GadgetReboot/16x16_Analog_Switch/README.md

# I2C Controlled 16x16_Analog_Switch
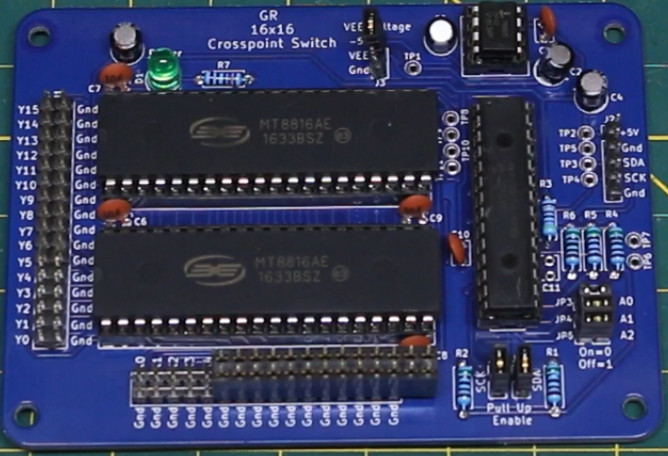
[picture p1: Assembled_PCB.jpg]
PCB
<br><br><BR><BR>
MT8816 based 16x16 Analog Switch Matrix
