GadgetReboot/16x16_Analog_Switch/GR_MT8816_Breakout_Sch.pdf

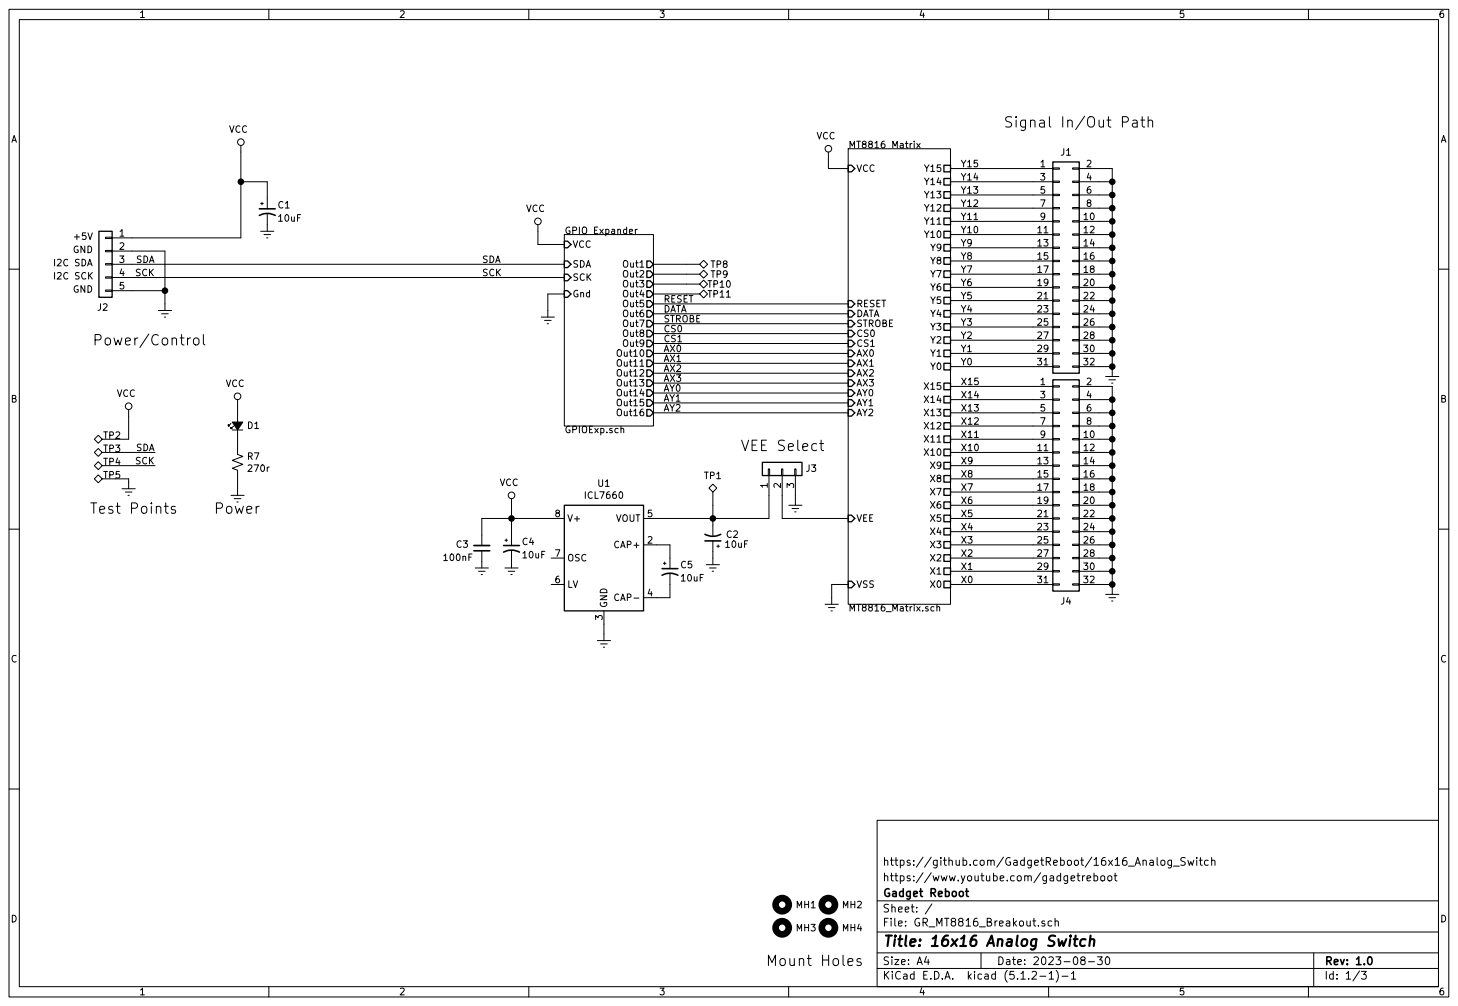
[picture p2: page 1]

J1 Signal In/Out Path

J3 VEE SelectVCC GPIO Expander

9 | 10
11 | 12

21 | 22
23 | 24
25 | 26
27 | 28
29 | 30
31 | 32

13 | 14
15 | 16
17 | 18
19 | 20

https://github.com/GadgetReboot/16x16_Analog_Switch
https://www.youtube.com/gadgetreboot
File: GR_MT8816_Breakout.sch Sheet: / Gadget Reboot

Id: 1/3 Title: 16x16 Analog Switch

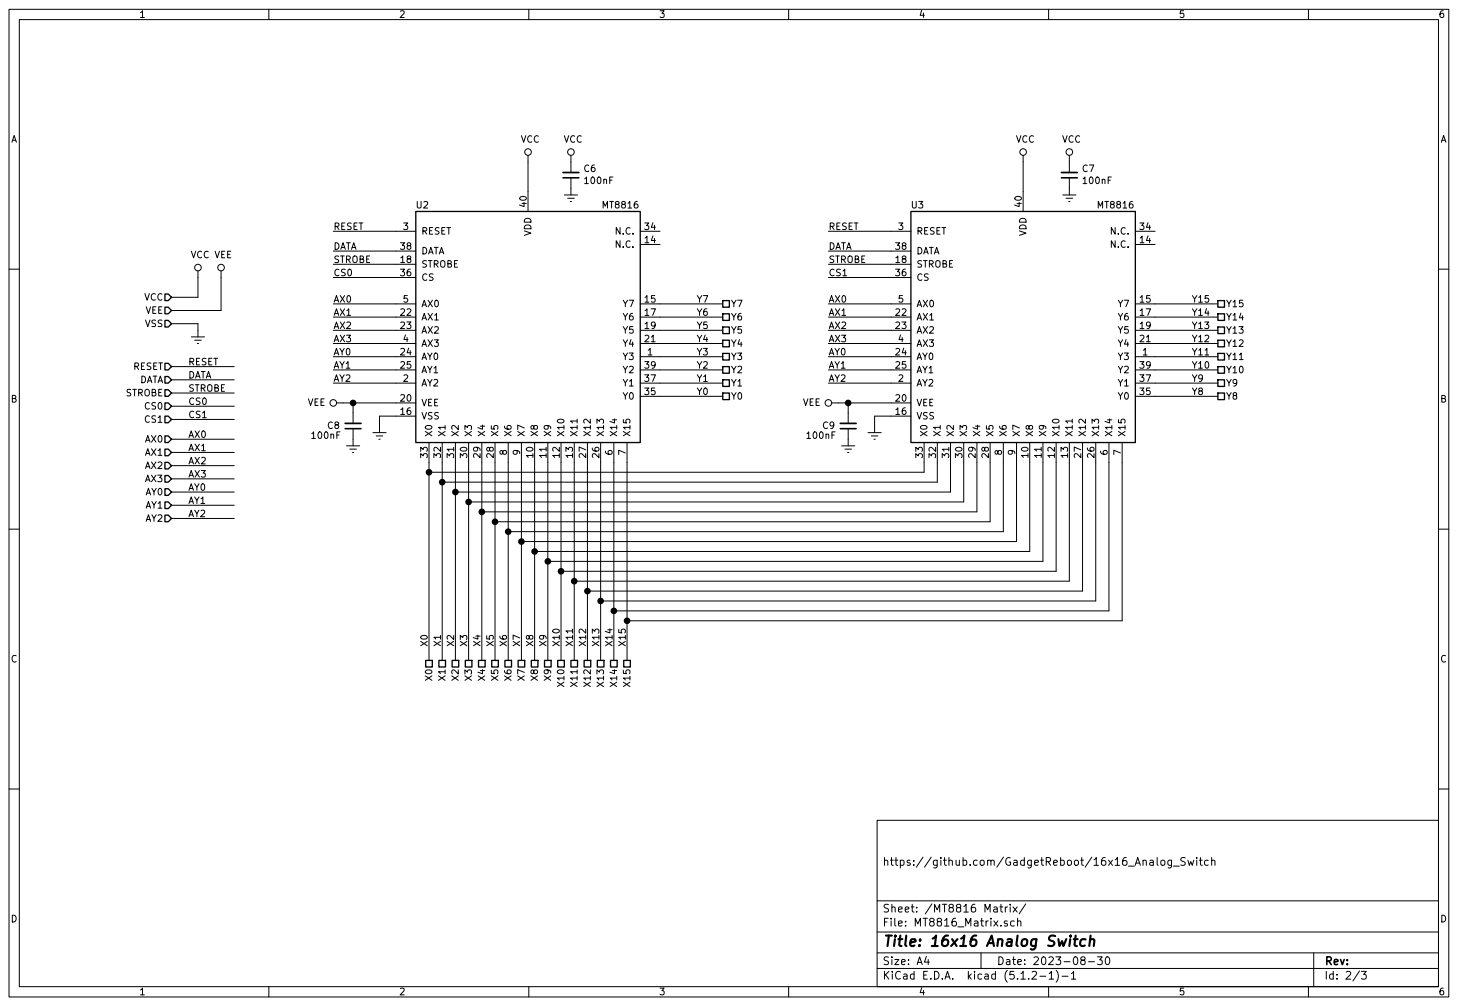
[picture p3: page 2]

9 U2 MT8816 Y3 1 X8 10 X9 11 X10 12 X11 13 N.C. 14 Y7 15 VSS 16 Y6 17 STROBE 18 Y5 19 AY2 2 VEE 20 Y4 21 AX1 22 AX2 23 AY0 24 AY1 25 X13 26 X12 27 X5 28 X4 29 RESET 3 X3 30 X2 31 X1 32 X0 33 N.C. 34 Y0 35 CS 36 Y1 37 DATA 38 Y2 39 AX3 4 VDD 40 AX0 5 X14

File: MT8816_Matrix.sch Sheet: /MT8816 Matrix/ https://github.com/GadgetReboot/16x16_Analog_Switch

Id: 2/3 Title: 16x16 Analog Switch

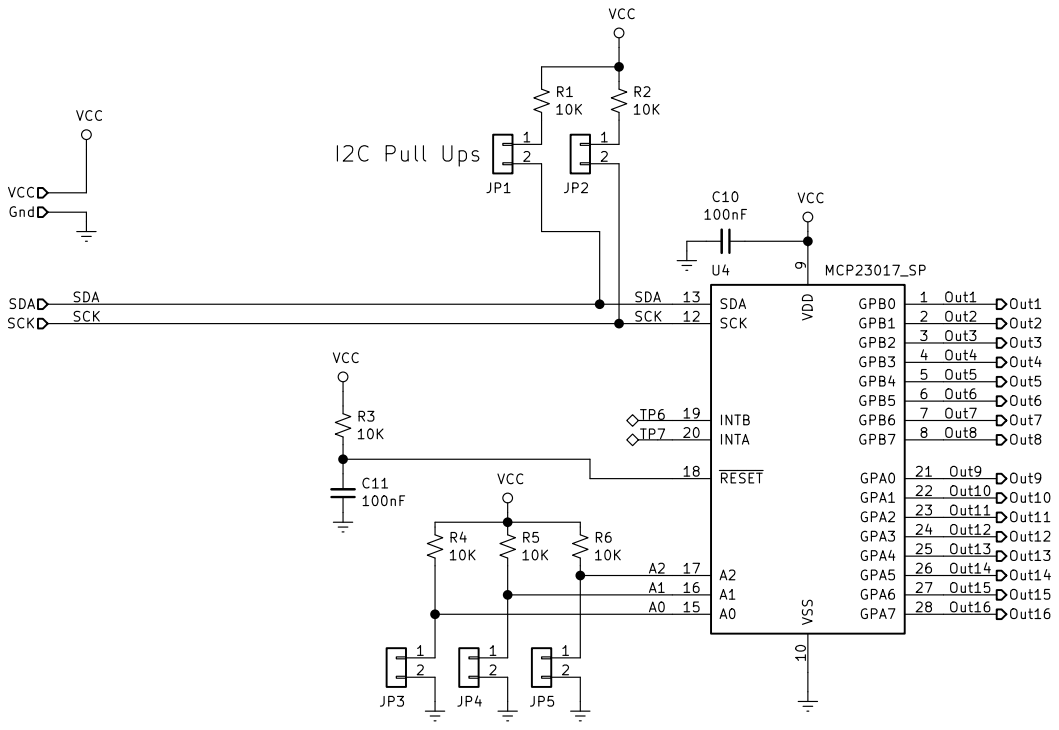
[picture p4: page 3]

https://github.com/GadgetReboot/16x16_Analog_Switch

Sheet: /GPIO Expander/
File: GPIOExp.sch
Id: 3/3 Title: 16x16 Analog Switch
