GadgetReboot/16x16_Analog_Switch/KiCad/GR_MT8816_Breakout.kicad_pcb

## KiCad design KiCad/GR_MT8816_Breakout.kicad_pcb (2023-08-31)

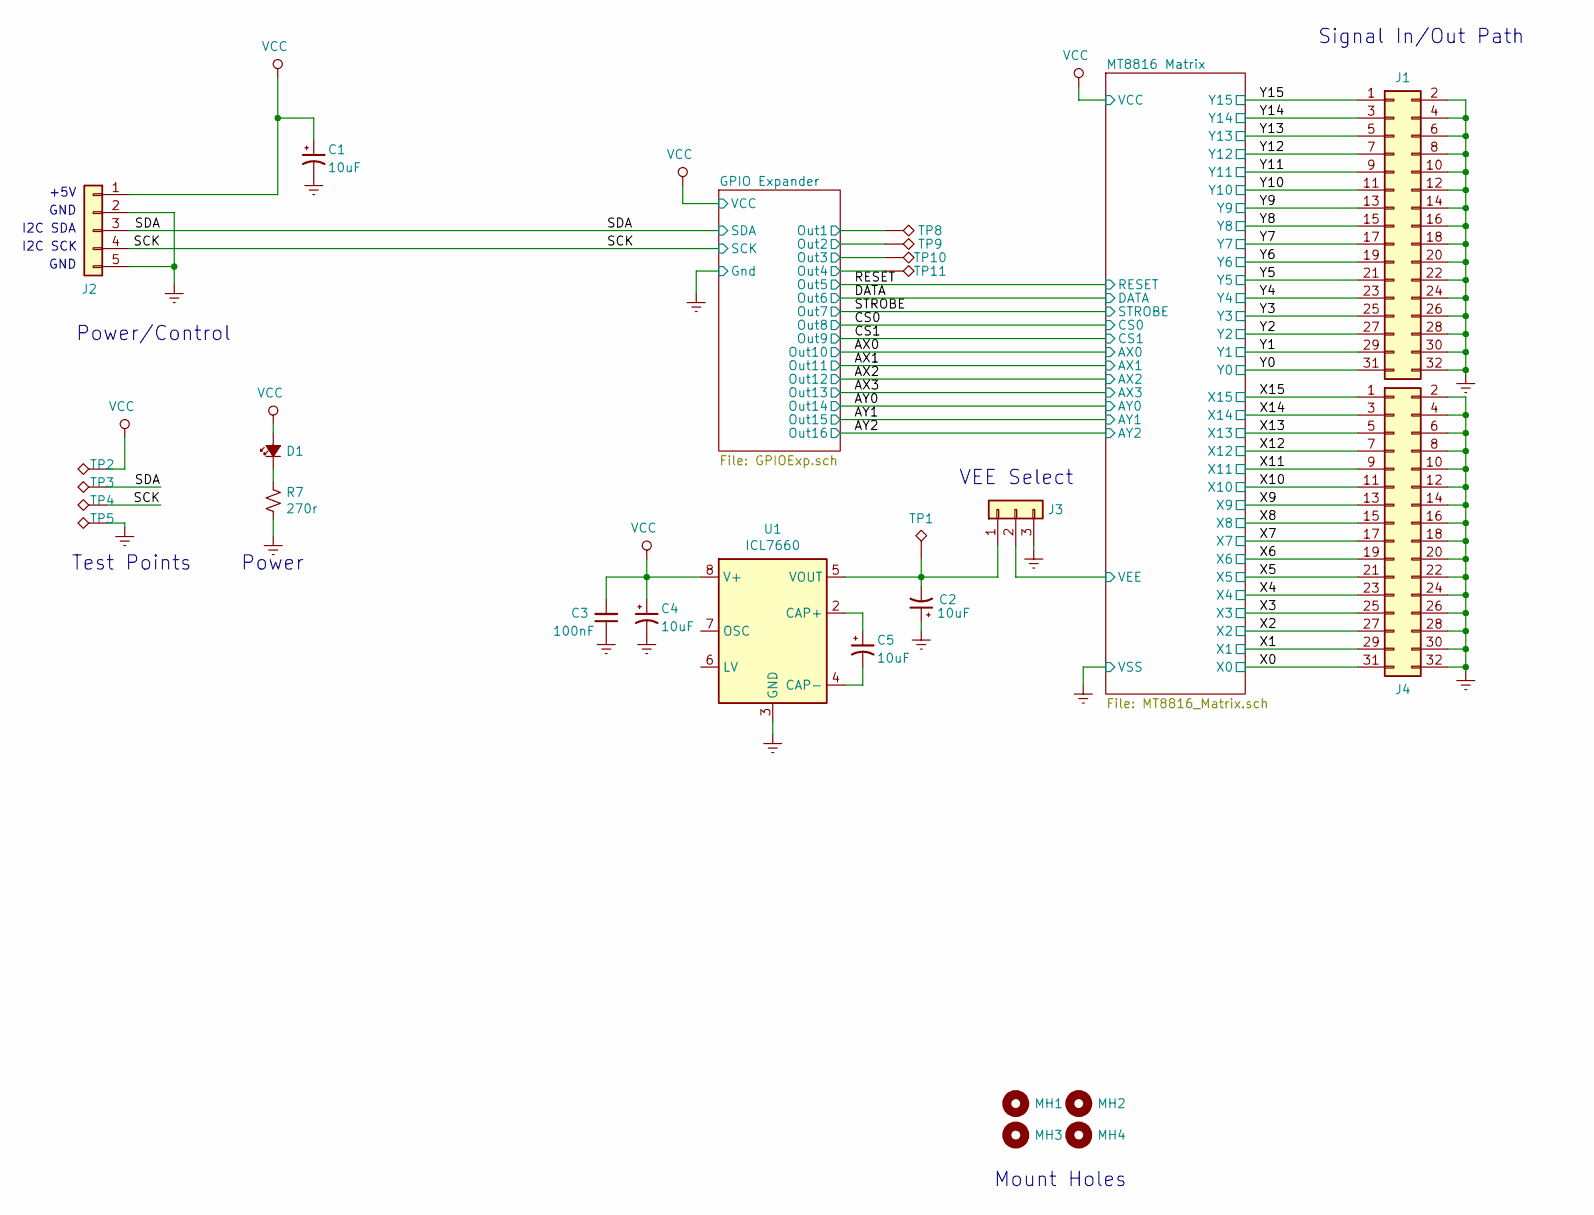
[picture p5: schematic GR_MT8816_Breakout.sch, 16x16 Analog Switch]

Parts:
C1, C2, C4, C5: 10uF; CP_Radial_D5.0mm_P2.50mm
C3: 100nF; C_Disc_D3.8mm_W2.6mm_P2.50mm
D1: LED_Small_ALT; LED_D5.0mm
J1, J4: Conn_02x16_Odd_Even; PinHeader_2x16_P2.54mm_Vertical
J2: Conn_01x05; PinHeader_1x05_P2.54mm_Vertical
J3: Conn_01x03; PinHeader_1x03_P2.54mm_Vertical
MH1, MH2, MH3, MH4: MountingHole; MountingHole_3.2mm_M3
R7: 270r; R_Axial_DIN0207_L6.3mm_D2.5mm_P7.62mm_Horizontal
TP1, TP2, TP3, TP4, TP5, TP8, TP9, TP10, TP11: TestPoint_Alt; TestPoint_THTPad_D2.0mm_Drill1.0mm
U1: ICL7660; DIP-8_W7.62mm_Socket_LongPads

Connections:
/GPIO Expander/Out1: TP8.1; also elsewhere on the board
/GPIO Expander/Out2: TP9.1; also elsewhere on the board
/GPIO Expander/Out3: TP10.1; also elsewhere on the board
/GPIO Expander/Out4: TP11.1; also elsewhere on the board
/SCK: J2.4, TP4.1; also elsewhere on the board
/SDA: J2.3, TP3.1; also elsewhere on the board
/X0: J4.31; also elsewhere on the board
/X1: J4.29; also elsewhere on the board
/X2: J4.27; also elsewhere on the board
/X3: J4.25; also elsewhere on the board
/X4: J4.23; also elsewhere on the board
/X5: J4.21; also elsewhere on the board
/X6: J4.19; also elsewhere on the board
/X7: J4.17; also elsewhere on the board
/X8: J4.15; also elsewhere on the board
/X9: J4.13; also elsewhere on the board
/X10: J4.11; also elsewhere on the board
/X11: J4.9; also elsewhere on the board
/X12: J4.7; also elsewhere on the board
/X13: J4.5; also elsewhere on the board
/X14: J4.3; also elsewhere on the board
/X15: J4.1; also elsewhere on the board
/Y0: J1.31; also elsewhere on the board
/Y1: J1.29; also elsewhere on the board
/Y2: J1.27; also elsewhere on the board
/Y3: J1.25; also elsewhere on the board
/Y4: J1.23; also elsewhere on the board
/Y5: J1.21; also elsewhere on the board
/Y6: J1.19; also elsewhere on the board
/Y7: J1.17; also elsewhere on the board
/Y8: J1.15; also elsewhere on the board
/Y9: J1.13; also elsewhere on the board
/Y10: J1.11; also elsewhere on the board
/Y11: J1.9; also elsewhere on the board
/Y12: J1.7; also elsewhere on the board
/Y13: J1.5; also elsewhere on the board
/Y14: J1.3; also elsewhere on the board
/Y15: J1.1; also elsewhere on the board
GNDREF: C1.2, C2.1, C3.1, C4.2, J1.2, J1.4, J1.6, J1.8, J1.10, J1.12, J1.14, J1.16, J1.18, J1.20, J1.22, J1.24, J1.26, J1.28, J1.30, J1.32, J2.2, J2.5, J3.3, J4.2, J4.4, J4.6, J4.8, J4.10, J4.12, J4.14, J4.16, J4.18, J4.20, J4.22, J4.24, J4.26, J4.28, J4.30, J4.32, R7.2, TP5.1, U1.3 (GND); also elsewhere on the board
unnamed: C2.2, J3.1, TP1.1, U1.5 (VOUT)
unnamed: C5.1, U1.2 (CAP+)
unnamed: C5.2, U1.4 (CAP-)
unnamed: D1.1 (K), R7.1
VCC: C1.1, C3.2, C4.1, D1.2 (A), J2.1, TP2.1, U1.8 (V+); also elsewhere on the board
VEE: J3.2; also elsewhere on the board

Notes on the sheet:
Power/Control
Mount Holes
+5V
I2C SDA
I2C SCK
GND
Test Points
Signal In/Out Path
VEE Select
Power

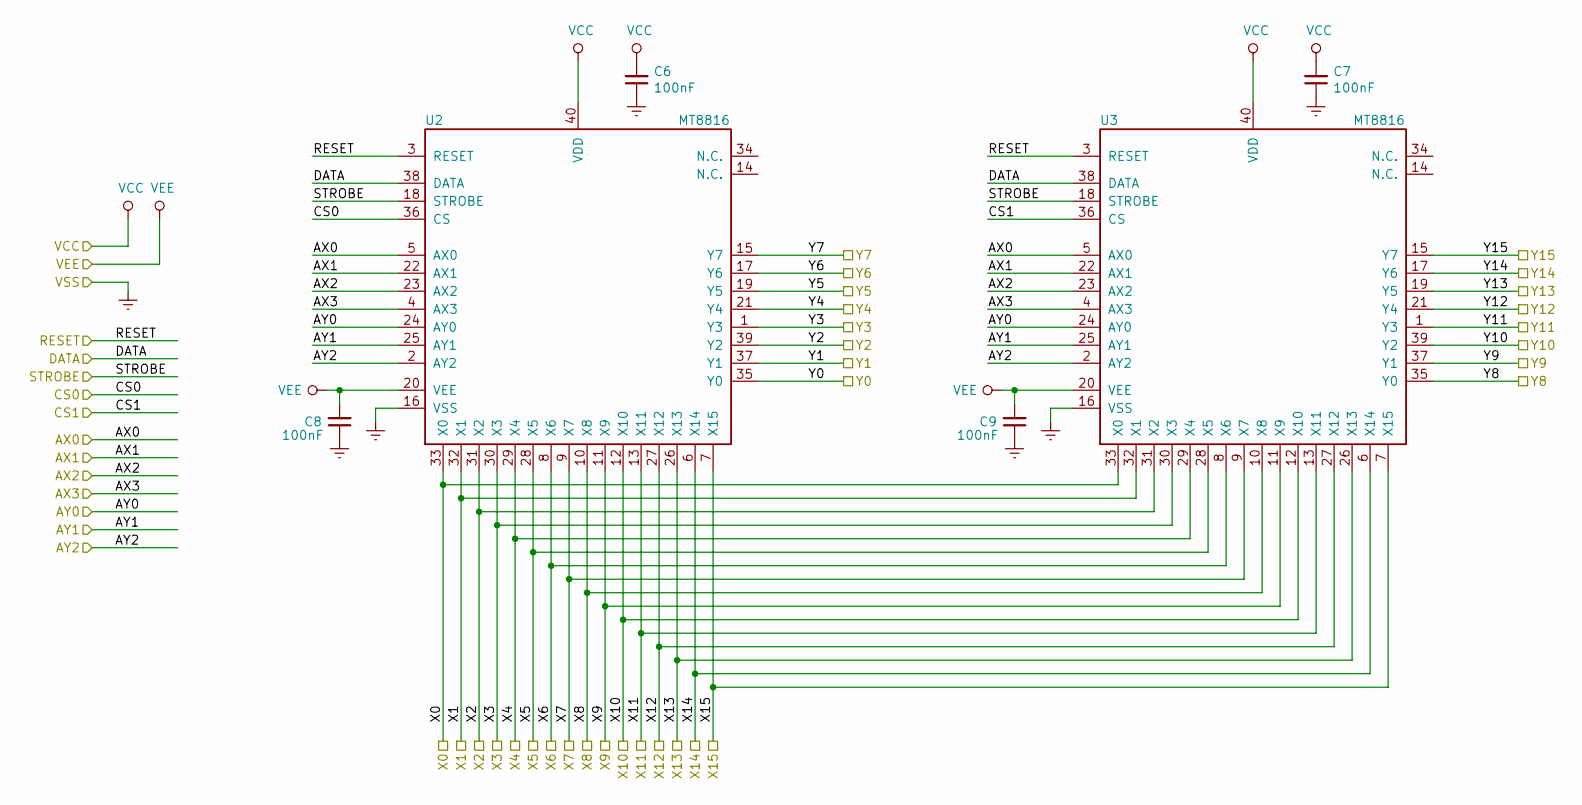
[picture p6: schematic MT8816_Matrix.sch, 16x16 Analog Switch]

Parts:
C6, C7, C8, C9: 100nF; C_Disc_D3.8mm_W2.6mm_P2.50mm
U2, U3: MT8816; DIP-40_W15.24mm_Socket_LongPads

Connections:
/AX0: U2.5 (AX0), U3.5 (AX0); also elsewhere on the board
/AX1: U2.22 (AX1), U3.22 (AX1); also elsewhere on the board
/AX2: U2.23 (AX2), U3.23 (AX2); also elsewhere on the board
/AX3: U2.4 (AX3), U3.4 (AX3); also elsewhere on the board
/AY0: U2.24 (AY0), U3.24 (AY0); also elsewhere on the board
/AY1: U2.25 (AY1), U3.25 (AY1); also elsewhere on the board
/AY2: U2.2 (AY2), U3.2 (AY2); also elsewhere on the board
/CS0: U2.36 (CS); also elsewhere on the board
/CS1: U3.36 (CS); also elsewhere on the board
/DATA: U2.38 (DATA), U3.38 (DATA); also elsewhere on the board
/RESET: U2.3 (RESET), U3.3 (RESET); also elsewhere on the board
/STROBE: U2.18 (STROBE), U3.18 (STROBE); also elsewhere on the board
/X0: U2.33 (X0), U3.33 (X0); also elsewhere on the board
/X1: U2.32 (X1), U3.32 (X1); also elsewhere on the board
/X2: U2.31 (X2), U3.31 (X2); also elsewhere on the board
/X3: U2.30 (X3), U3.30 (X3); also elsewhere on the board
/X4: U2.29 (X4), U3.29 (X4); also elsewhere on the board
/X5: U2.28 (X5), U3.28 (X5); also elsewhere on the board
/X6: U2.8 (X6), U3.8 (X6); also elsewhere on the board
/X7: U2.9 (X7), U3.9 (X7); also elsewhere on the board
/X8: U2.10 (X8), U3.10 (X8); also elsewhere on the board
/X9: U2.11 (X9), U3.11 (X9); also elsewhere on the board
/X10: U2.12 (X10), U3.12 (X10); also elsewhere on the board
/X11: U2.13 (X11), U3.13 (X11); also elsewhere on the board
/X12: U2.27 (X12), U3.27 (X12); also elsewhere on the board
/X13: U2.26 (X13), U3.26 (X13); also elsewhere on the board
/X14: U2.6 (X14), U3.6 (X14); also elsewhere on the board
/X15: U2.7 (X15), U3.7 (X15); also elsewhere on the board
/Y0: U2.35 (Y0); also elsewhere on the board
/Y1: U2.37 (Y1); also elsewhere on the board
/Y2: U2.39 (Y2); also elsewhere on the board
/Y3: U2.1 (Y3); also elsewhere on the board
/Y4: U2.21 (Y4); also elsewhere on the board
/Y5: U2.19 (Y5); also elsewhere on the board
/Y6: U2.17 (Y6); also elsewhere on the board
/Y7: U2.15 (Y7); also elsewhere on the board
/Y8: U3.35 (Y0); also elsewhere on the board
/Y9: U3.37 (Y1); also elsewhere on the board
/Y10: U3.39 (Y2); also elsewhere on the board
/Y11: U3.1 (Y3); also elsewhere on the board
/Y12: U3.21 (Y4); also elsewhere on the board
/Y13: U3.19 (Y5); also elsewhere on the board
/Y14: U3.17 (Y6); also elsewhere on the board
/Y15: U3.15 (Y7); also elsewhere on the board
GNDREF: C6.1, C7.1, C8.1, C9.1, U2.16 (VSS), U3.16 (VSS); also elsewhere on the board
VCC: C6.2, C7.2, U2.40 (VDD), U3.40 (VDD); also elsewhere on the board
VEE: C8.2, C9.2, U2.20 (VEE), U3.20 (VEE); also elsewhere on the board

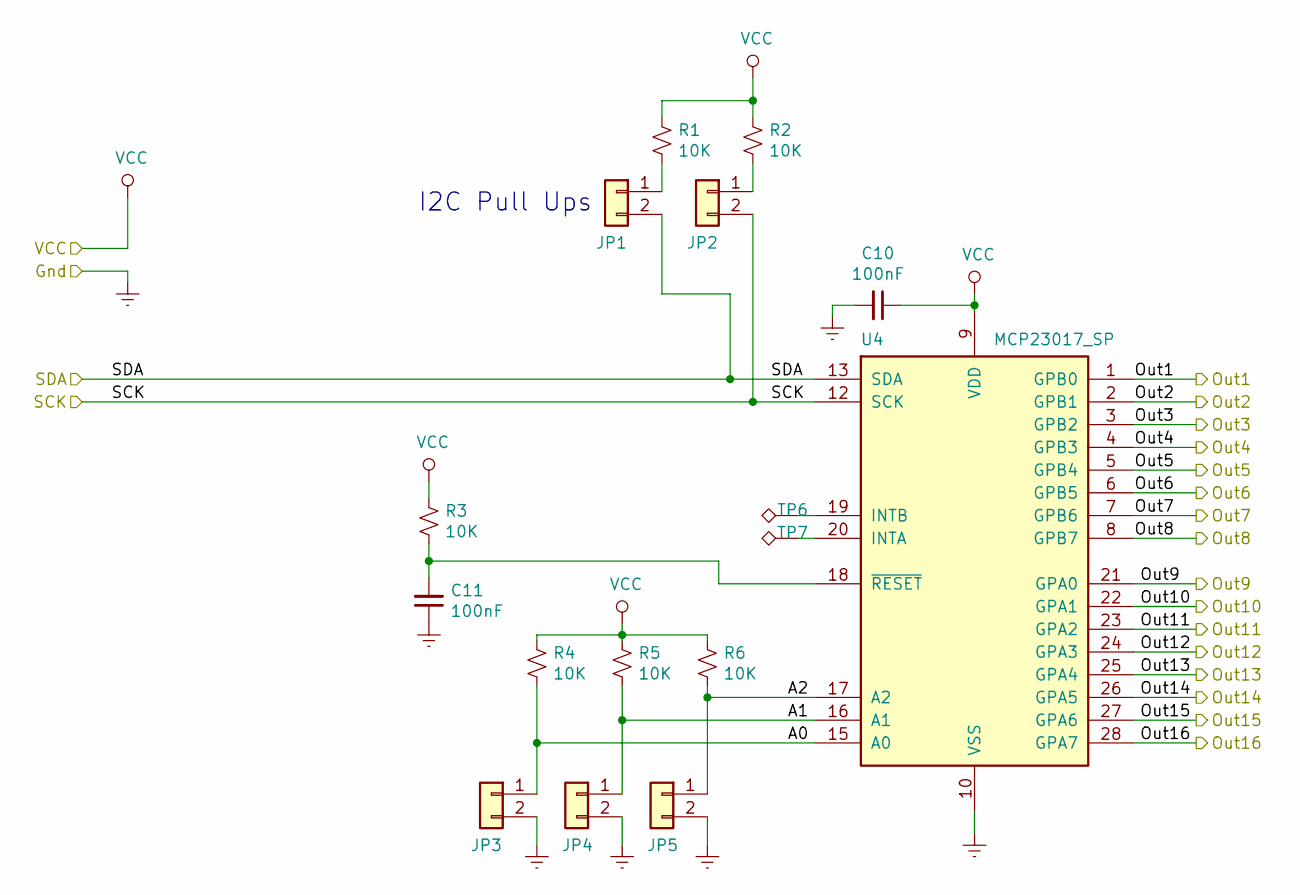
[picture p7: schematic GPIOExp.sch, 16x16 Analog Switch]

Parts:
C10, C11: 100nF; C_Disc_D3.8mm_W2.6mm_P2.50mm
JP1, JP2, JP3, JP4, JP5: Conn_01x02; PinHeader_1x02_P2.54mm_Vertical
R1, R2, R3, R4, R5, R6: 10K; R_Axial_DIN0207_L6.3mm_D2.5mm_P7.62mm_Horizontal
TP6, TP7: TestPoint_Alt; TestPoint_THTPad_D2.0mm_Drill1.0mm
U4: MCP23017_SP; DIP-28_W7.62mm

Connections:
/AX0: U4.22 (GPA1); also elsewhere on the board
/AX1: U4.23 (GPA2); also elsewhere on the board
/AX2: U4.24 (GPA3); also elsewhere on the board
/AX3: U4.25 (GPA4); also elsewhere on the board
/AY0: U4.26 (GPA5); also elsewhere on the board
/AY1: U4.27 (GPA6); also elsewhere on the board
/AY2: U4.28 (GPA7); also elsewhere on the board
/CS0: U4.8 (GPB7); also elsewhere on the board
/CS1: U4.21 (GPA0); also elsewhere on the board
/DATA: U4.6 (GPB5); also elsewhere on the board
/GPIO Expander/A0: JP3.1, R4.2, U4.15 (A0)
/GPIO Expander/A1: JP4.1, R5.2, U4.16 (A1)
/GPIO Expander/A2: JP5.1, R6.2, U4.17 (A2)
/GPIO Expander/Out1: U4.1 (GPB0); also elsewhere on the board
/GPIO Expander/Out2: U4.2 (GPB1); also elsewhere on the board
/GPIO Expander/Out3: U4.3 (GPB2); also elsewhere on the board
/GPIO Expander/Out4: U4.4 (GPB3); also elsewhere on the board
/RESET: U4.5 (GPB4); also elsewhere on the board
/SCK: JP2.2, U4.12 (SCK); also elsewhere on the board
/SDA: JP1.2, U4.13 (SDA); also elsewhere on the board
/STROBE: U4.7 (GPB6); also elsewhere on the board
GNDREF: C10.2, C11.1, JP3.2, JP4.2, JP5.2, U4.10 (VSS); also elsewhere on the board
unnamed: C11.2, R3.2, U4.18 (~RESET~)
unnamed: JP1.1, R1.2
unnamed: JP2.1, R2.2
unnamed: TP6.1, U4.19 (INTB)
unnamed: TP7.1, U4.20 (INTA)
VCC: C10.1, R1.1, R2.1, R3.1, R4.1, R5.1, R6.1, U4.9 (VDD); also elsewhere on the board

Notes on the sheet:
I2C Pull Ups

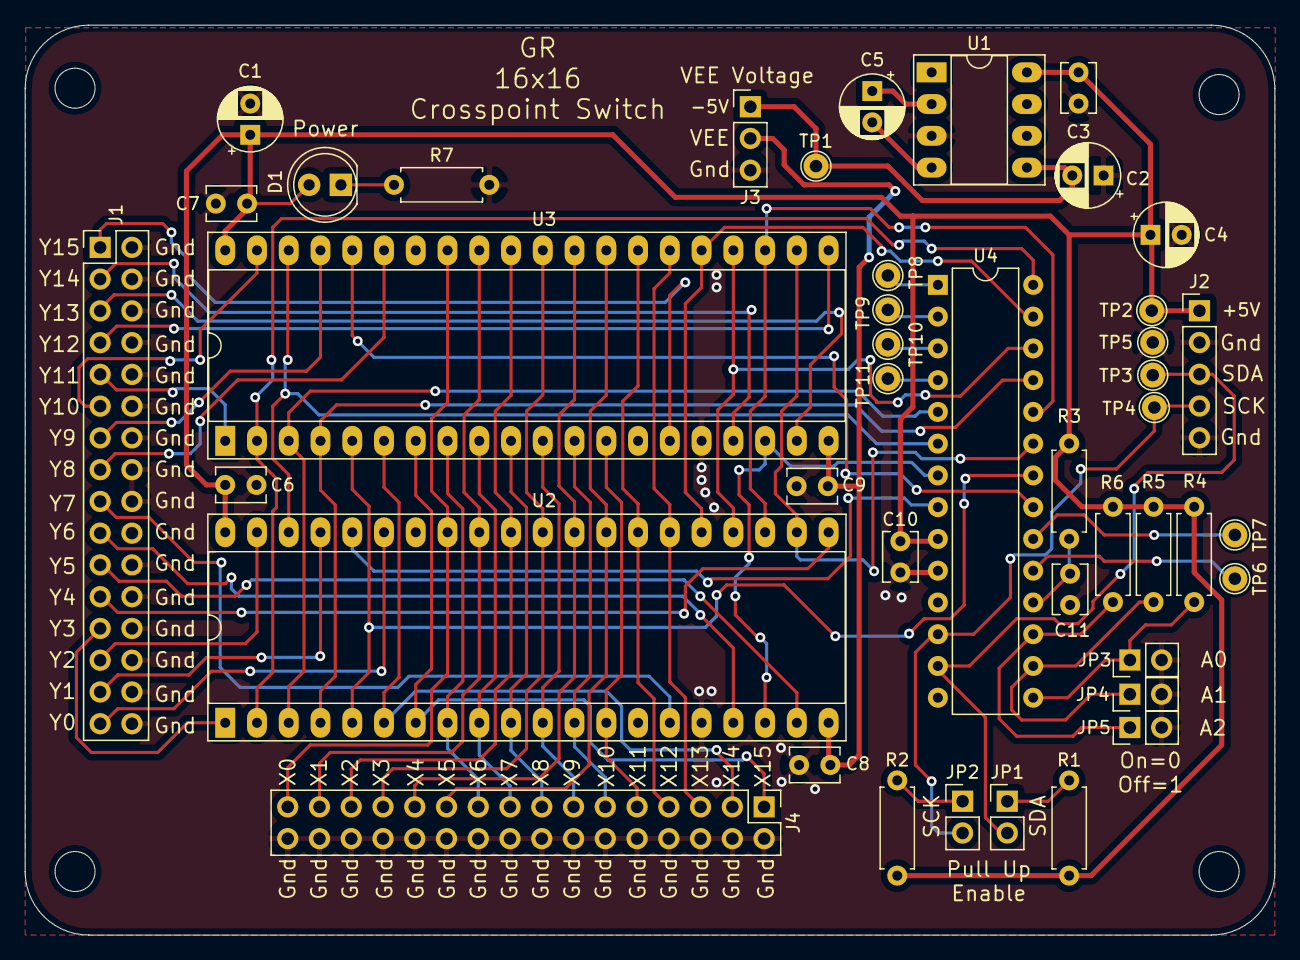
[picture p8: board GR_MT8816_Breakout.kicad_pcb from above]

Board: 2 copper layers, 99.9 x 72.8 mm, 47 parts (0 on the bottom side), 65 nets.
